Paarseus/AVL-IGVC2026/design_report/drafts/mechanical/figures/drivetrain_block.tex

% Drivetrain signal chain: Jetson -> Teensy -> 2x SparkMAX -> 2x NEO -> Tracks.
% 48 V bus across the top with explicit stubs into each SparkMAX.
% Every edge carries a rate stamp so the figure stands alone.
\begin{tikzpicture}[
    font=\footnotesize,
    >={Stealth[length=2mm, width=1.5mm]},
    compute/.style={draw=black!85, rounded corners, fill=cppgreen!12,
                    minimum width=2.2cm, minimum height=0.95cm, align=center},
    mcu/.style={draw=black!85, rounded corners, fill=orange!18,
                    minimum width=2.2cm, minimum height=0.95cm, align=center},
    drv/.style={draw=black!85, rounded corners, fill=codeblue!12,
                    minimum width=2.2cm, minimum height=0.95cm, align=center},
    motor/.style={draw=black!85, circle, fill=black!10, minimum size=1.05cm,
                    align=center, inner sep=1pt},
    % Tracks: distinct hexagonal "wheel-and-belt" silhouette so they don't
    % visually conflate with the SparkMAX rectangles
    track/.style={draw=black!85, thick, fill=black!22, minimum width=1.7cm,
                    minimum height=0.65cm, align=center, pattern=horizontal lines,
                    pattern color=black!50, rounded corners=6pt},
    busbar/.style={draw=warnred!85, line width=2.0pt, fill=warnred!12,
                    minimum width=6.8cm, minimum height=0.40cm, align=center,
                    rounded corners=2pt},
    cmd/.style={->, thick, black!75},                              % solid medium black
    can/.style={->, thick, codeblue!85, densely dashdotted},       % dash-dot for CAN
    pwr/.style={->, line width=1.6pt, warnred!85},                 % thick solid red
    fb/.style={->, semithick, gray!70!black, densely dashed},      % dashed gray for feedback
    mech/.style={line width=1.4pt, black!80},                      % shaft = thick solid black
    rate/.style={font=\scriptsize\itshape, gray!75!black, fill=white, inner sep=1pt},
    edgelbl/.style={font=\scriptsize, fill=white, inner sep=1pt},
    legend/.style={draw=black!45, very thin, rounded corners=2pt, fill=white,
                    inner sep=3pt, font=\scriptsize},
]

% ===================================================================
% NODES — placed on an explicit grid for visual alignment.
% SparkMAX L is offset slightly LEFT and R slightly RIGHT so that each
% gets its own visible 48 V stub from the bus bar above.
% ===================================================================
\node[compute] (jetson) at (0.0,  0.00) {Jetson Orin\\\textit{ROS\,2 Nav2}};
\node[mcu]     (teensy) at (3.6,  0.00) {Teensy 4.1\\\textit{motion bridge}};

\node[drv]   (spkL) at (6.8,  1.10) {SparkMAX L};
\node[drv]   (spkR) at (8.0, -1.10) {SparkMAX R};

\node[motor] (neoL) at ( 9.6, 1.10) {NEO\,L};
\node[motor] (neoR) at (10.8,-1.10) {NEO\,R};

\node[track] (trkL) at (11.9, 1.10) {Track\,L};
\node[track] (trkR) at (13.1,-1.10) {Track\,R};

% 48 V bus bar centred above the two SparkMAXes (spans both stub x's)
\node[busbar] (bus) at (7.4, 2.85) {48\,V power bus};

% ===================================================================
% EDGES — every edge gets a rate stamp underneath
% ===================================================================

% 1) Jetson -> Teensy (USB command, 50 Hz)
\draw[cmd] (jetson) -- (teensy);
\node[edgelbl] at ($(jetson.east)!0.5!(teensy.west)+(0, 0.22)$) {\texttt{cmd\_vel}};
\node[rate]   at ($(jetson.east)!0.5!(teensy.west)+(0,-0.22)$) {USB\,\textbar\,50\,Hz};

% 2) Teensy -> CAN -> both SparkMAX  (1 Mbit/s)
\coordinate (canjct) at ($(teensy.east)+(1.0,0)$);
\draw[can] (teensy.east) -- (canjct);
\draw[can] (canjct) |- (spkL.west);
\draw[can] (canjct) |- (spkR.west);
\node[rate, anchor=south] at ($(teensy.east)!0.5!(canjct)+(0, 0.10)$) {CAN\,\textbar\,1\,Mbit/s};

% 3) 48 V bus -> two stubs into each SparkMAX  (DC supply)
\draw[pwr] (bus.south -| spkL.north) -- (spkL.north);
\draw[pwr] (bus.south -| spkR.north) -- (spkR.north);
\node[rate, anchor=west] at ($(bus.south -| spkL.north)+(0.10,-0.18)$) {+48\,V};
\node[rate, anchor=west] at ($(bus.south -| spkR.north)+(0.10, 0.18)$) {+48\,V};

% 4) SparkMAX -> NEO (3-phase PWM, ~20 kHz switching)
\draw[pwr] (spkL.east) -- (neoL.west);
\draw[pwr] (spkR.east) -- (neoR.west);
\node[rate, anchor=south] at ($(spkL.east)!0.5!(neoL.west)+(0, 0.10)$) {3$\phi$\,PWM\,\textbar\,20\,kHz};
\node[rate, anchor=south] at ($(spkR.east)!0.5!(neoR.west)+(0, 0.10)$) {3$\phi$\,PWM\,\textbar\,20\,kHz};

% 5) NEO -> Track  (mechanical shaft coupling)
\draw[mech] (neoL.east) -- (trkL.west);
\draw[mech] (neoR.east) -- (trkR.west);
\node[rate, anchor=south] at ($(neoL.east)!0.5!(trkL.west)+(0, 0.10)$) {shaft};
\node[rate, anchor=south] at ($(neoR.east)!0.5!(trkR.west)+(0, 0.10)$) {shaft};

% 6) Hall-effect encoder feedback: NEO -> SparkMAX (routed through the
%    middle gap between the two rows; never shares an axis with 3-phase power)
\draw[fb] (neoL.south) .. controls +(0,-0.55) and +(1.0,-0.55) .. (spkL.south east);
\node[rate, anchor=north] at ($(spkL.south east)!0.5!(neoL.south)+(0,-0.42)$)
    {Hall\,\textbar\,1\,kHz};

\draw[fb] (neoR.north) .. controls +(0,0.55) and +(1.0,0.55) .. (spkR.north east);
\node[rate, anchor=south] at ($(spkR.north east)!0.5!(neoR.north)+(0, 0.42)$)
    {Hall\,\textbar\,1\,kHz};

% ===================================================================
% Closed-loop annotation: brace below the SparkMAX/NEO group
% ===================================================================
\draw[decorate, decoration={brace, amplitude=4pt, mirror}, gray!70!black, thin]
    ($(spkR.south west)+(0,-1.10)$) -- ($(neoR.south east)+(0,-1.10)$);
\node[font=\scriptsize, gray!70!black]
    at ($(spkR.south)!0.5!(neoR.south)+(0,-1.50)$)
    {1\,kHz velocity PID loop closed inside SparkMAX (per side)};

% ===================================================================
% LEGEND (below the brace, horizontal) — uses BOTH color AND line style
% so it remains parseable for color-blind readers
% ===================================================================
\node[legend, anchor=north] at (6.3, -3.40) {
    \begin{tikzpicture}[baseline=0pt, x=0.6cm]
        \draw[pwr] (0, 0) -- (0.9, 0);
        \node[anchor=west, font=\scriptsize] at (0.95, 0) {power (48\,V / 3$\phi$)};
        \draw[can] (5.5, 0) -- (6.4, 0);
        \node[anchor=west, font=\scriptsize] at (6.45, 0) {CAN bus};
        \draw[cmd] (9.5, 0) -- (10.4, 0);
        \node[anchor=west, font=\scriptsize] at (10.45, 0) {command};
        \draw[fb] (13.0, 0) -- (13.9, 0);
        \node[anchor=west, font=\scriptsize] at (13.95, 0) {feedback};
        \draw[mech] (16.5, 0) -- (17.4, 0);
        \node[anchor=west, font=\scriptsize] at (17.45, 0) {mech.\ shaft};
    \end{tikzpicture}
};

\end{tikzpicture}
