Paarseus/AVL-IGVC2026/design_report/drafts/autonomy/figures/electrical_p1_img1.png

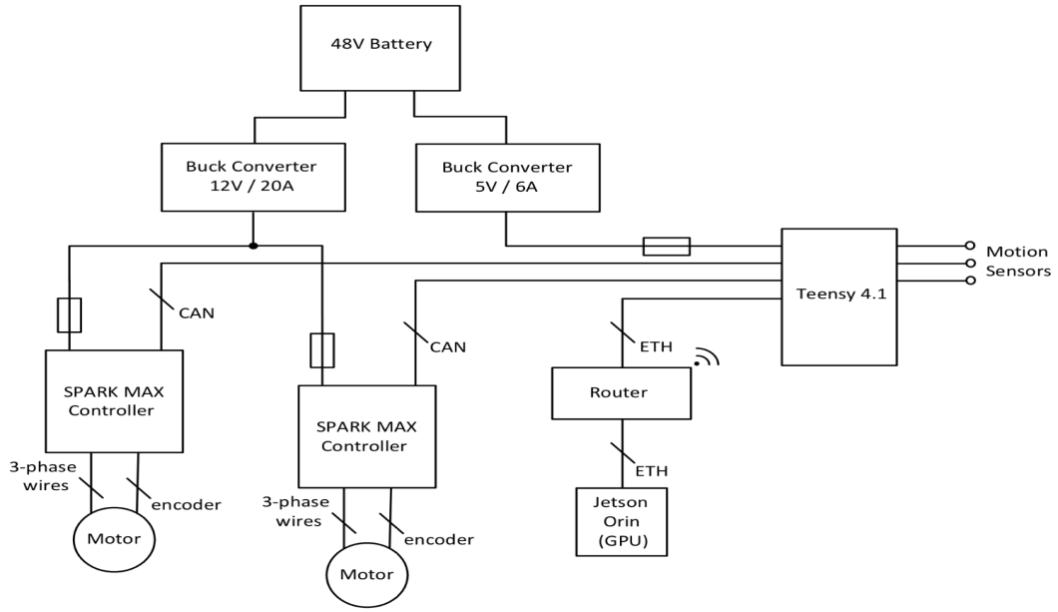
design_report/drafts/autonomy/figures/electrical_p1_img1.png
