Paarseus/AVL-IGVC2026/design_report/drafts/autonomy/figures/electrical_p2_img1.jpeg

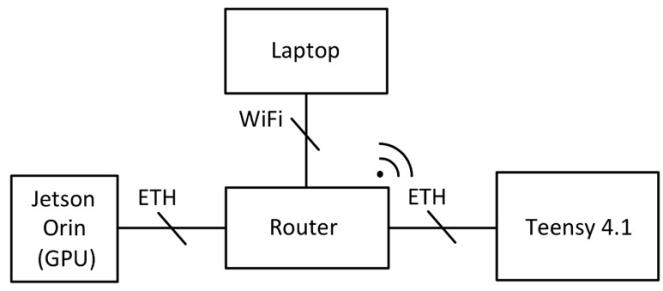
design_report/drafts/autonomy/figures/electrical_p2_img1.jpeg
