Paarseus/AVL-IGVC2026/design_report/drafts/autonomy/figures/mech_image1.png

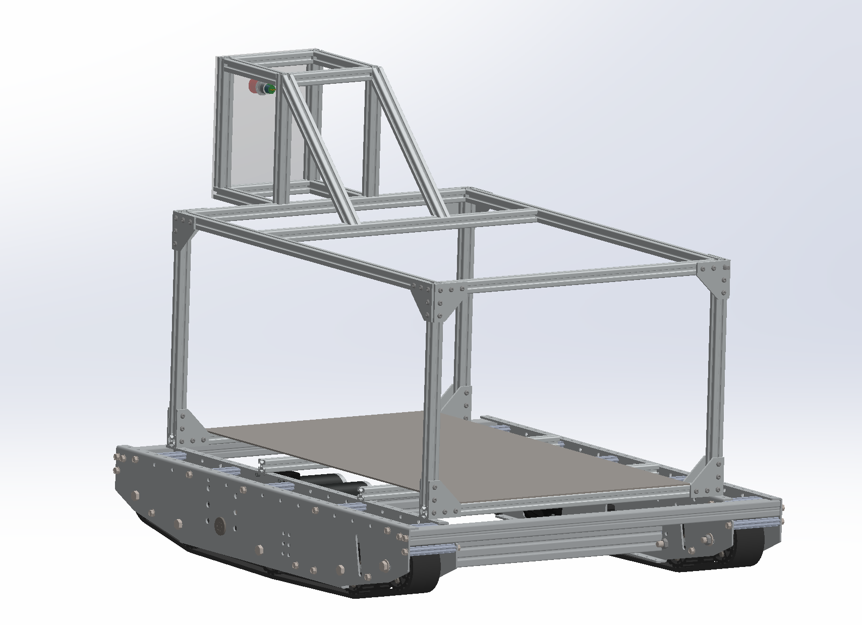
design_report/drafts/autonomy/figures/mech_image1.png
