Paarseus/AVL-IGVC2026/design_report/drafts/autonomy/figures/mech_image2.png

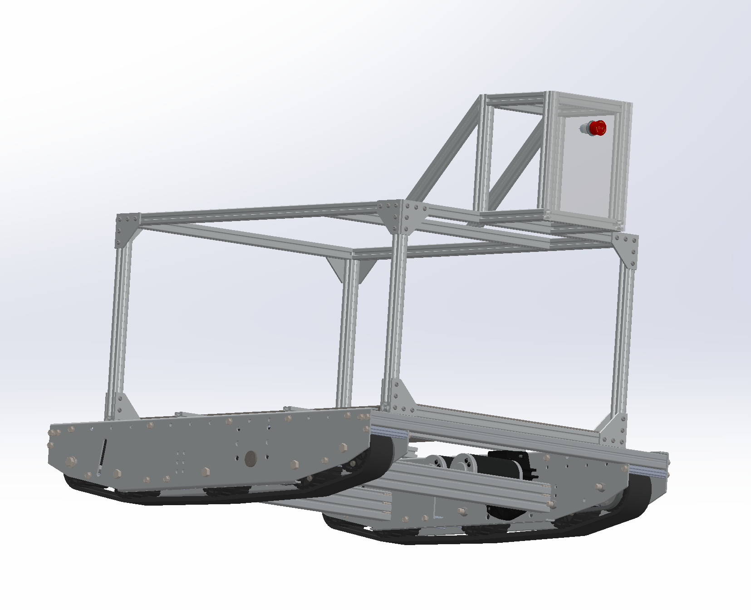
design_report/drafts/autonomy/figures/mech_image2.png
