Paarseus/AVL-IGVC2026/design_report/drafts/autonomy/figures/perception_pipeline.png

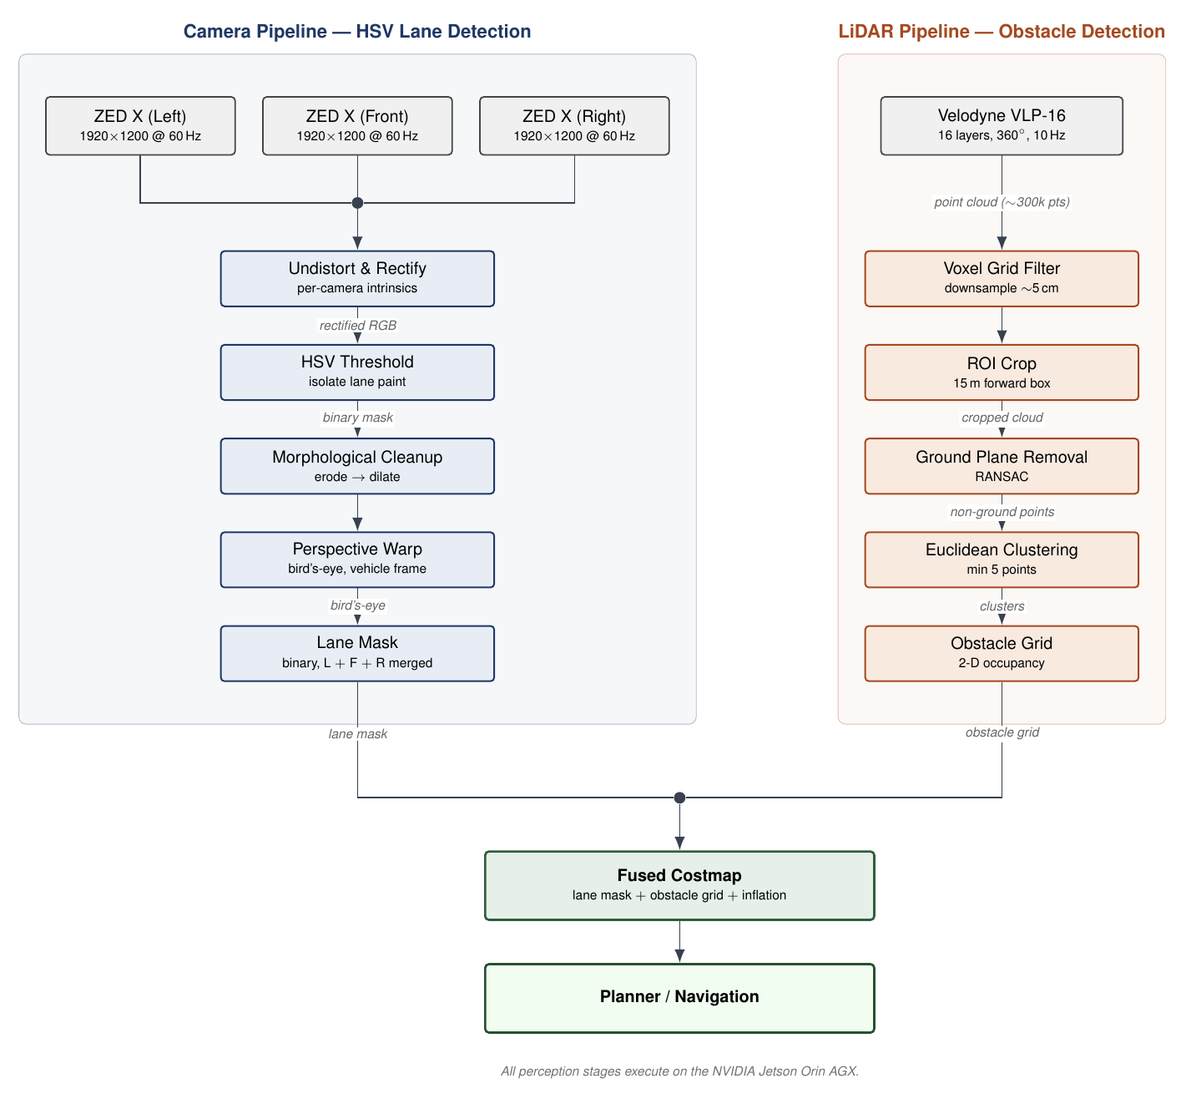
design_report/drafts/autonomy/figures/perception_pipeline.png
