Paarseus/AVL-IGVC2026/design_report/drafts/autonomy/figures/perception_pipeline.pdf

Camera Pipeline — HSV Lane Detection | LiDAR Pipeline — Obstacle Detection

## ZED X (Left)

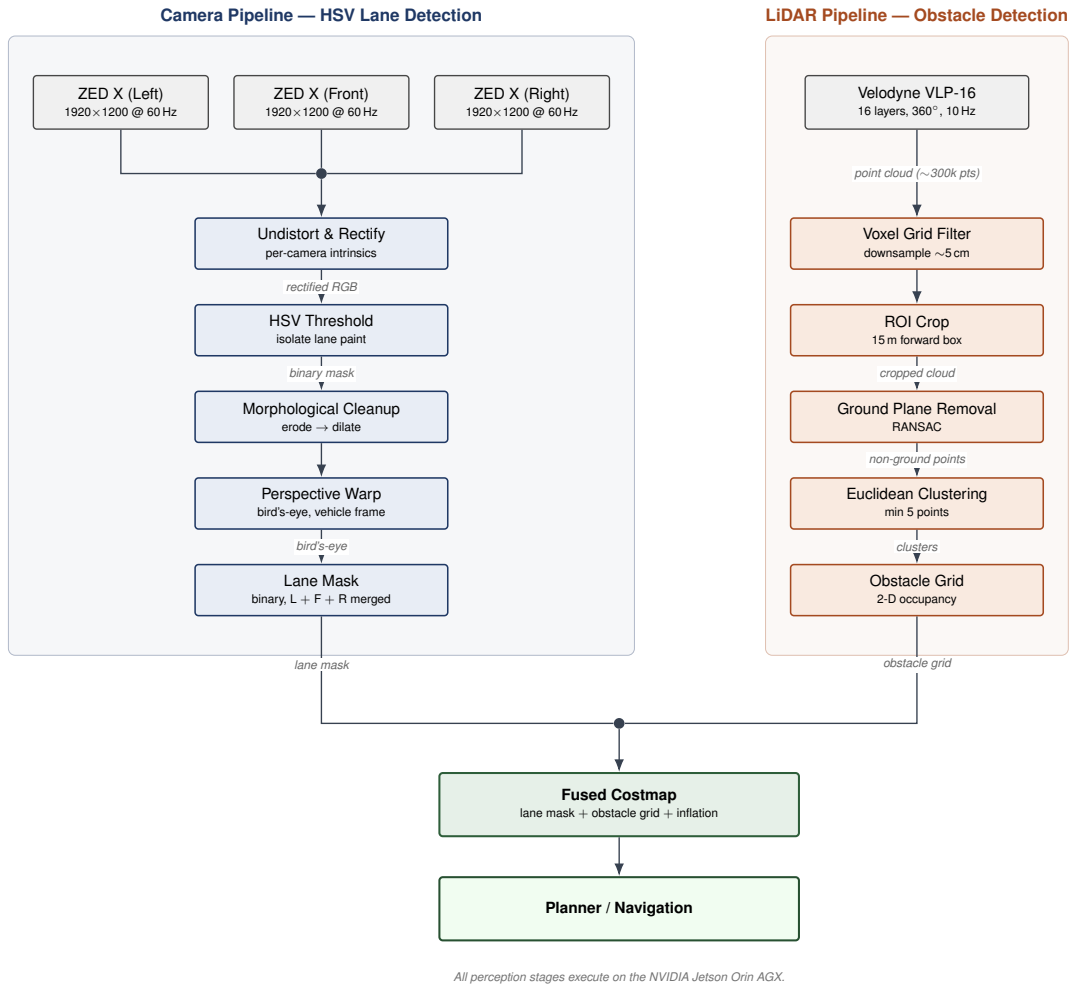
[picture p14: page 1]
ZED X (Front); ZED X (Right); Morphological Cleanup; erode → dilate; Lane Mask; binary, L + F + R merged; Velodyne VLP-16; 16 layers, 360◦; ROI Crop; 15 m forward box; RANSAC; Euclidean Clustering; min 5 points; Obstacle Grid; 2-D occupancy; Fused Costmap; Planner / Navigation; rectified RGB; binary mask; bird’s-eye; cropped cloud; clusters; lane mask; obstacle grid

point cloud (∼300k pts)

Undistort & Rectify
per-camera intrinsics

Voxel Grid Filter
downsample ∼5 cm

HSV Threshold
isolate lane paint

Ground Plane Removal

non-ground points

Perspective Warp
bird’s-eye, vehicle frame

lane mask + obstacle grid + inflation

All perception stages execute on the NVIDIA Jetson Orin AGX.
