Paarseus/AVL-IGVC2026/(commit log)

2026-03-11 Add Teensy 4.1 SparkMAX CAN firmware and protocol docs
    Initial firmware for driving 2 REV SparkMAX motor controllers
    over CAN bus from a Teensy 4.1, plus full CAN protocol reference.
2026-03-12 Add SparkMAX fw 26.1.4 compatible CAN controller sketch
    New firmware 26 sketch with Universal Heartbeat (0x01011840),
    Secondary Heartbeat fallback, encoder feedback via STATUS_2
    (API Class 46), and SET_STATUSES_ENABLED support. Single motor,
    CAN ID 1.
2026-04-13 Fill in sensor suite details in design report
    Replace TODO placeholders with concrete sensor selections (3x ZED X
    stereo cameras, Velodyne VLP-16 LiDAR, Xsens MTi-680G GNSS/INS),
    expand the perception section into separate HSV lane detection and
    LiDAR obstacle detection pipelines, and add the perception pipeline
    figure.
2026-04-13 Fill in sensor suite details in design report
    LiDAR obstacle detection pipelines, and reference the new perception
    pipeline figure.
    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
2026-04-19 Add teensy diff-drive firmware and update design report
    Adds firmware/teensy_diff_drive/ with the USB-Serial<->CAN bridge sketch
    for the Teensy 4.1, its bring-up test plan, and a CLAUDE.md. Also updates
    the design report with a new perception pipeline figure and accompanying
    text.
2026-04-25 Update teensy diff-drive firmware and add bench-test phase scripts
2026-05-16 Reorganize design_report into per-section drafts and references
    - design_report/drafts/{autonomy,mechanical,electrical}/ each hold one teammate's section draft
    - design_report/references/ for external reference docs (OU power design)
    - Untrack LaTeX build artifacts (main.aux/log/out/toc/pdf, perception_pipeline.aux/log) and add .gitignore inside the autonomy LaTeX project
    - Root .gitignore for .claude/ and sample_design_reports/ (local reference library)
2026-05-16 Add mechanical design section as LaTeX with TikZ figures
    Port the mechanical_2026.docx draft into a standalone main.tex matching the
    autonomy/electrical house style (cppgreen palette, fancyhdr, titlesec). Add
    six figures: two existing CAD renders plus five new TikZ diagrams that the
    prose previously lacked --- side-view weight distribution, top-view
    dimensioned chassis, three-mode differential-drive kinematics, drivetrain
    signal chain, and the two-channel hardware E-stop schematic. Layouts in the
    side and top views were corrected from the docx description (which placed
    the battery at the rear) to match the actual CAD: battery centered on the
    deck, payload at the front, CoG biased slightly fo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
2026-05-16 Polish mechanical TikZ figures via critique-fix iteration loop
    Run multi-pass aesthetic review (independent vision-agent critic +
    re-render) on the five non-CAD figures. Apply the consolidated changes:
    - Mute and consolidate the color palette across all figures; reserve
    saturated safety-red strictly for the E-stop break path, CoG marker,
    and hardware-enforced boundary; demote previously-saturated battery
    and payload fills to a soft blue/green pair.
    - Establish a line-weight hierarchy (object > dimension > centerline >
    hidden) and move dimensions into clean witness-line margins outside
    the part outline rather than overlaying it.
    - Add body-frame coordinate markers (x_b, y_b/z_b) an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
2026-05-16 Deep polish on Fig 4 (kinematics) and Fig 5 (drivetrain)
    Focused multi-agent feedback loop on the two figures flagged for more
    iteration. Use sequential-thinking to plan revisions, then run a vision
    critic over each version until it reaches publication quality.
    Figure 4 (differential-drive kinematics):
    - Add a forward-pointing nose triangle to the body so each panel reads
    unambiguously as a top-view top-facing-up vehicle.
    - Make velocity-arrow lengths strictly proportional to |v| across all
    three panels, with a fixed reference length of 1.0 cm = v.
    - Anchor the ICR marker on the actual physically-correct contact patch
    in panel (a) (left-track centerline) with a horizontal radius line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
2026-05-16 Restructure design report to IGVC 2026 AutoNav format
    - Rewrite main.tex to match IGVC 2026 rule IV.3 9-section structure
    (System Requirements, Mechanical, Safety, Electrical, Perception,
    Driving Logic, KPIs, Analysis, Cyber Security)
    - Add per-section requirements-compliance tables with target vs measured
    - Migrate content from autonomy, mechanical, and electrical drafts
    - Set robot name to MARVIN; fill captain/advisor contacts and date
    - Add Aegis 48V 25Ah LiFePO4 battery and DC House 48V 18A charger;
    compute runtime and recharge estimates
    - Populate BOM with researched vendor prices ($13,754.77 market cost)
    - Trim figures and tables to fit the 15-page AutoNav limit
    - Add design_repo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
2026-05-16 Fill in §3.1 Transport, Parked, Charging Safety
    Replaces the placeholder block with four short paragraphs covering
    transport (web-UI joystick lab-to-meadow + strapped in cargo van to
    Michigan), parked state (mechanical E-stop latched, main switch off),
    bench testing (workstation lift for drivetrain work), and charging
    (in-lab only, keyed charge port, IP65 charger with overcurrent /
    overvoltage / overheat / reverse-polarity / short-circuit protections,
    LiFePO4 thermal stability, fire extinguisher nearby, unattended permitted).
2026-05-16 Fill in §8.5 sim-vs-real differences
    Replaces the placeholder with a 4-bullet compact paragraph covering
    (i) GPS noise, (ii) lighting variation, (iii) suspension/IMU vibration,
    (iv) timing latency, each cross-referenced to the existing design
    decision it motivates. Also removes the §3.1 bench-testing paragraph
    (not rule-required) to keep the body at the 15-page IGVC AutoNav limit.
2026-05-16 Restructure §9 cyber security into subsections + fit 15-page AutoNav limit
    Combines Parsa Ghasemi's expanded §9 cyber security content (ISO/SAE 21434
    TARA, STRIDE classification, CVE-2024-28231, Deng CCS 2022, JammerTest
    2024 / RTKiller references, NIST control IDs, defense-in-depth and
    production-roadmap paragraphs) with:
    - Conversion of the broken §9 tabularx into four \subsection blocks
    (V1 DDS, V2 web UI drive-by-wire, V3 GNSS spoofing, Defense in Depth)
    — the table format was wrapping cell prose into 3-char columns.
    - Compressed §8.5 sim-vs-real paragraph (4-bullet inline list).
    - Removal of §3.1 bench-testing paragraph (not rule-required).
    - Removal of §3.2 safe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
2026-05-16 Fill all measurement compliance cells; merge contributor table + §8.1
    Combines:
    - Parsa Ghasemi's team additions (six-student contributor table in §1.1,
    revised §9 cyber security with short-label table + Risk column,
    "six students" in §1.1 intro, lab→meadow narrative tweaks)
    - §8.1 Lessons Learned: user-supplied first-year reflection on budget
    constraints, financial-support effort, teamwork, and IGVC pride.
    - Christopher Sierra-Rodriguez as Key Team Member (secondary contact).
    - Measurement compliance cells: replaced 8 [Pending] placeholders with
    defensible calculated / by-design / nominal values:
    * Battery runtime: ~6.5 h calc; field burndown pending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
2026-05-16 Restore Behnam Bahr cursive signature above signature line; rear CAD on cover
